spakov/irbox/strings.cpp

#include "strings.h"

const char* lParenString = "(";
const char* rParenString = ")";
const char* commaString = ",";
const char* hexString = "0x";
const char* newlineString = "\r\n";
const char* okString = "+";
const char* errorString = "-";
const char* protocolString = "protocol ";
const char* rawString = ", raw ";
const char* unknownString = " unknown";
const char* busyString = " busy";
const char* wrongModeString = " wrong mode";
const char* atClientModeString = "AT+CWMODE=1";
const char* atJoinString = "AT+CWJAP=\"ssid\",\"password\"";
const char* atIPString = "AT+CIFSR";
const char* atMuxModeString = "AT+CIPMUX=1";
const char* atServerString = "AT+CIPSERVER=1,333";
const char* atSendString = "AT+CIPSEND=";
const char* connectString = ",CONNECT";
const char* connectFailString = ",CONNECT FAIL";
const char* closedString = ",CLOSED";
const char* ipdString = "+IPD,";
const char* nopString = "nop";
const char* rxString = "rx";
const char* norxString = "norx";
const char* txString = "tx";
